ohenley/kitchen_120/(commit log)

2026-11-02 fix oven run against wall
    [kitchen_data.scad]
2026-11-02 Add wall faucet KS413 as roughed in
    [kitchen_data.scad]
2026-11-02 Blind corner on the oven wall, oven centred at 73 1/4, receptacles recorded
    [kitchen.scad, kitchen_data.scad]
2026-11-02 Blind corner on the oven wall, oven centred at 73 1/4, 30 drawers at the corridor, receptacles recorded
    [kitchen_data.scad]
2026-11-02 wip olivier
    [kitchen.scad, kitchen_data.scad]
2026-11-02 Counter 25 1/2 on both walls, ply thickness note
    [construction.scad, kitchen.scad, kitchen_data.scad]
2026-11-03 Stainless counter with integral sink
    [kitchen_data.scad]
2026-11-03 apply patch
    [construction.scad, kitchen.scad, kitchen_data.scad]
